apiesse/knxRoomUnit/hardware/knxRoomUnit/production/knxRoomUnit_r1d1_2024-01-23_12-25-09/knxRoomUnit_r1d1.pdf

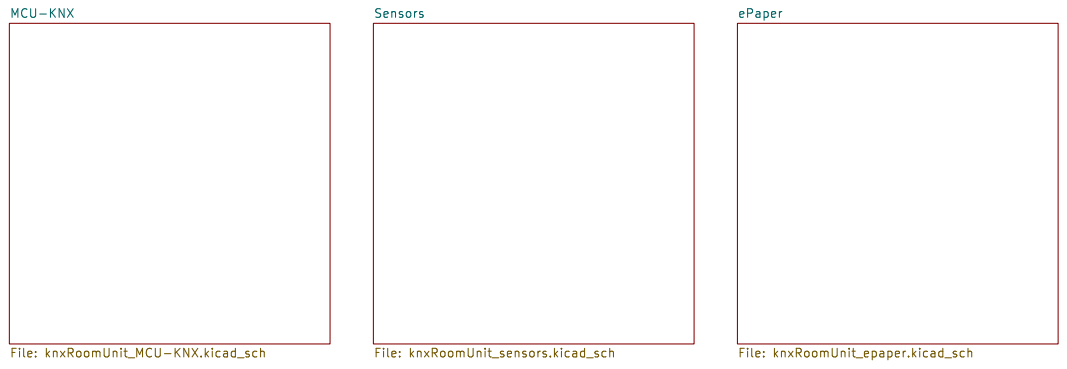
[picture p1: page 1]
D Date: 2024-01-21 KiCad; kicad; 7.0.10 Size: A4; Rev: r1d1; File: knxRoomUnit_MCU-KNX.kicad_sch

ePaper File: knxRoomUnit_epaper.kicad_sch Sensors File: knxRoomUnit_sensors.kicad_sch MCU-KNX

Id: 1/4 Title: knxRoomUnit File: knxRoomUnit.kicad_sch Sheet: / MP

# SW1 RESET R3

# R5 10k GND GND

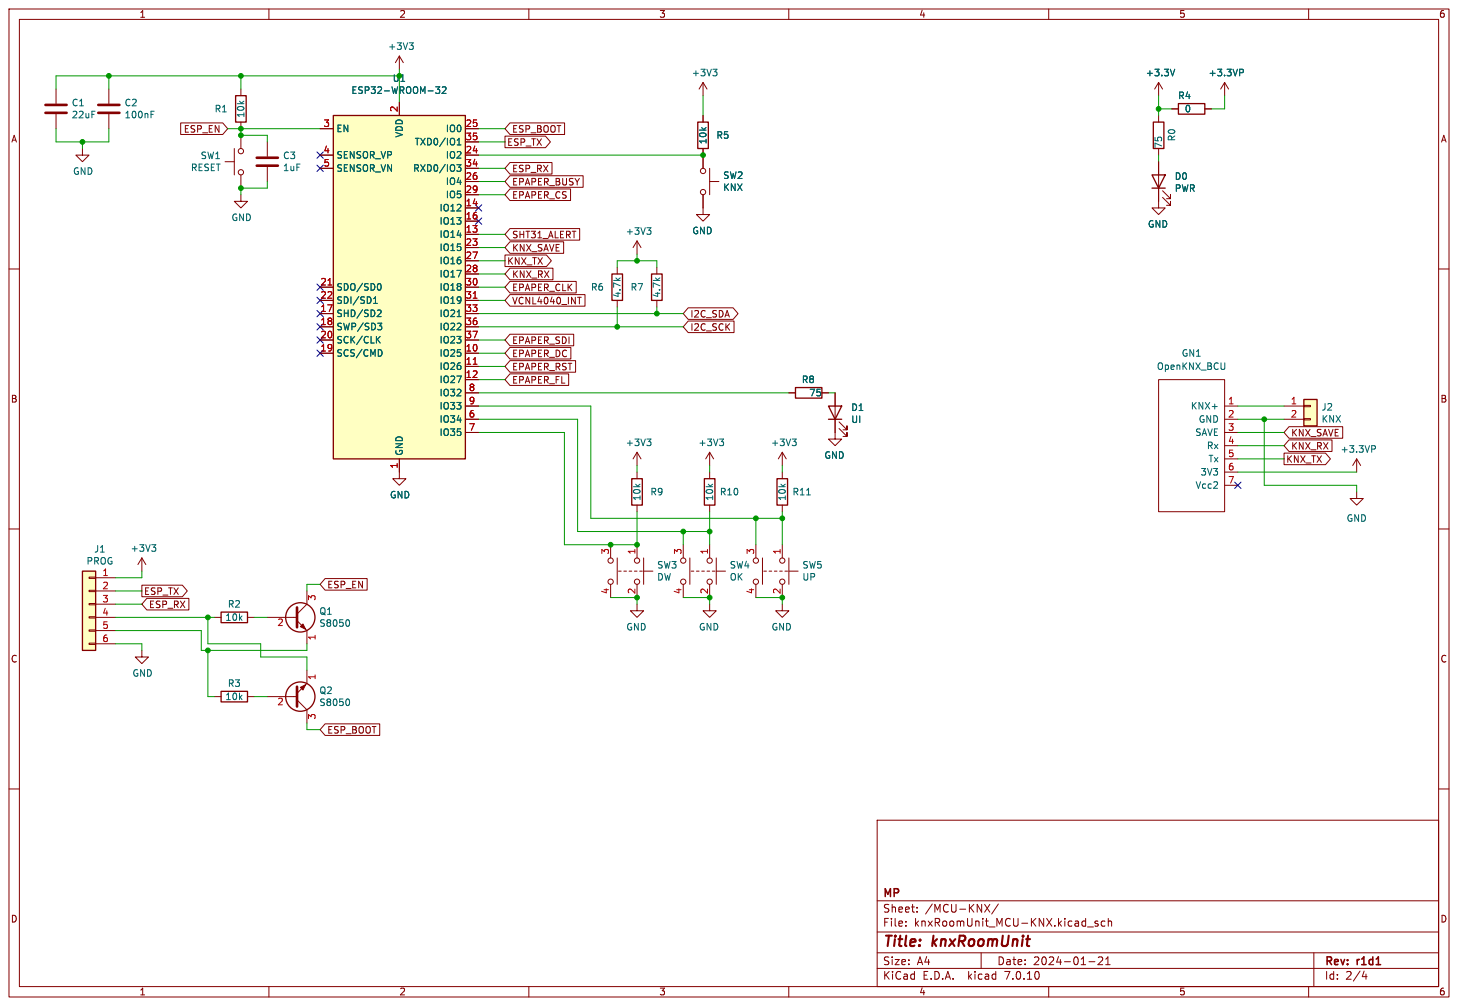
[picture p2: page 2]

2 SCK/CLK 20 SDO/SD0 21 SDI/SD1 22

3 Q1 S8050 KNX+ 1 GND 2 SAVE 3 Rx 4 Tx 5

Id: 2/4 Title: knxRoomUnit File: knxRoomUnit_MCU-KNX.kicad_sch Sheet: /MCU-KNX/ MP

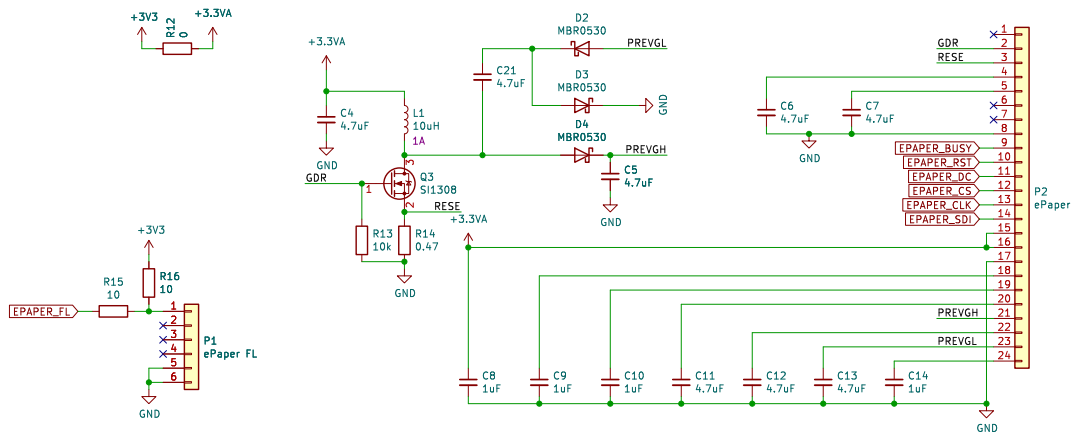
[picture p3: page 3]

Id: 3/4 Title: knxRoomUnit File: knxRoomUnit_epaper.kicad_sch Sheet: /ePaper/ MP

# Logic OSCI PD

0R19

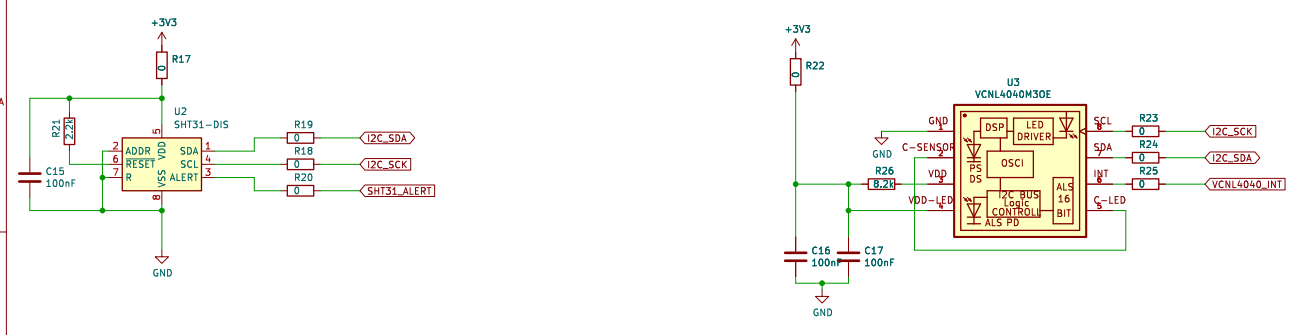
[picture p4: page 4]

Id: 4/4 Title: knxRoomUnit File: knxRoomUnit_sensors.kicad_sch Sheet: /Sensors/ MP

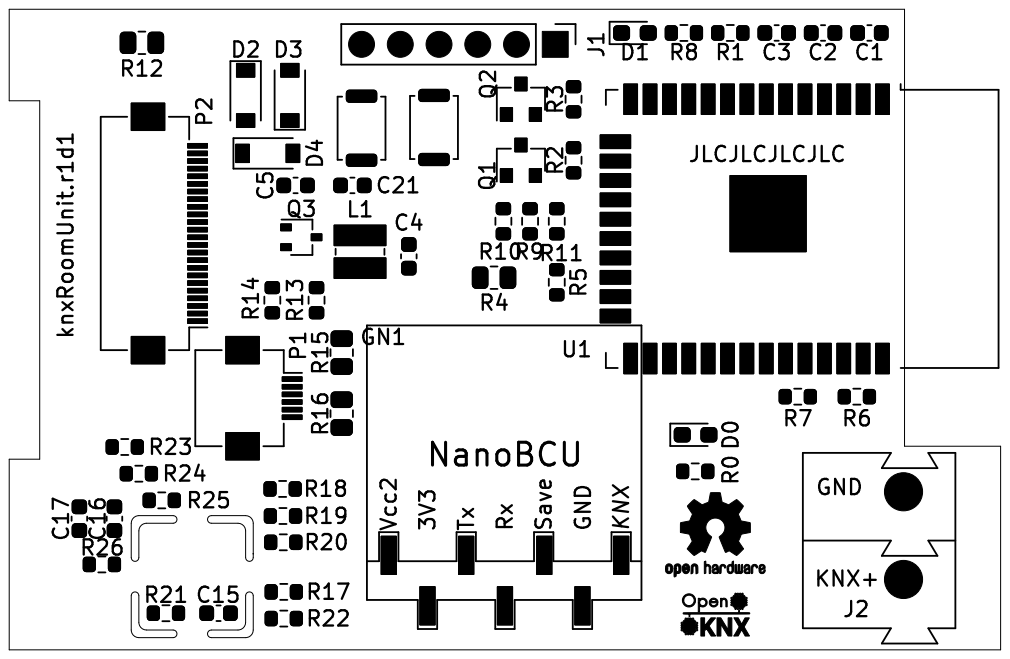
[picture p5: page 5]

Id: 1/1 Title: knxRoomUnit File: knxRoomUnit.kicad_pcb Sheet: MP

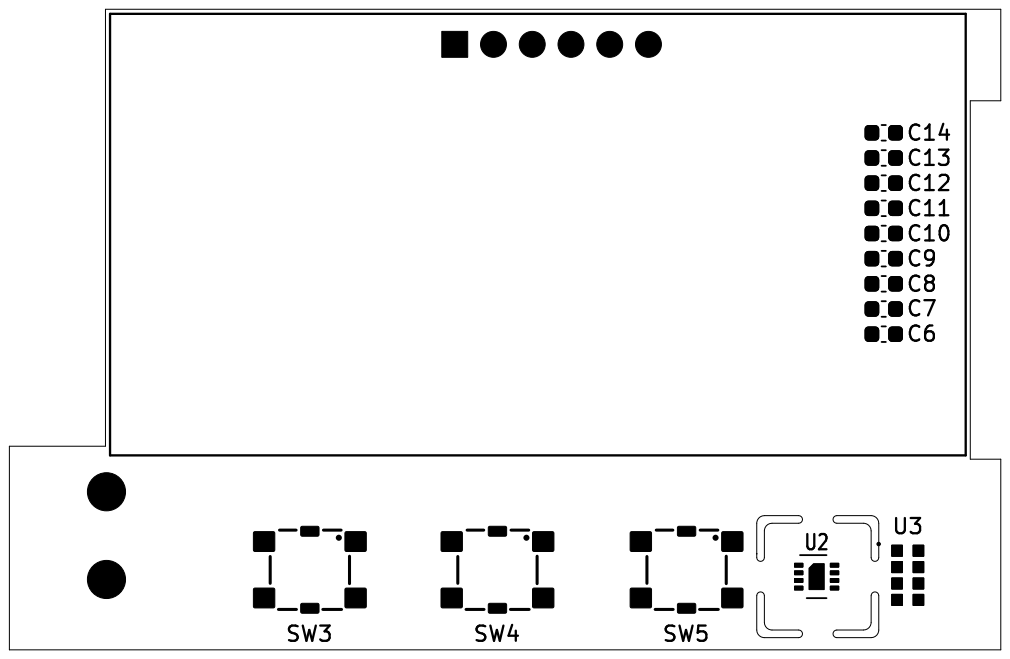
[picture p6: page 6]

Id: 1/1 Title: knxRoomUnit File: knxRoomUnit.kicad_pcb Sheet: MP
