apiesse/knxRoomUnit/hardware/knxRoomUnit/knxRoomUnit.kicad_pcb

## KiCad design hardware/knxRoomUnit/knxRoomUnit.kicad_pcb (2024-01-23)

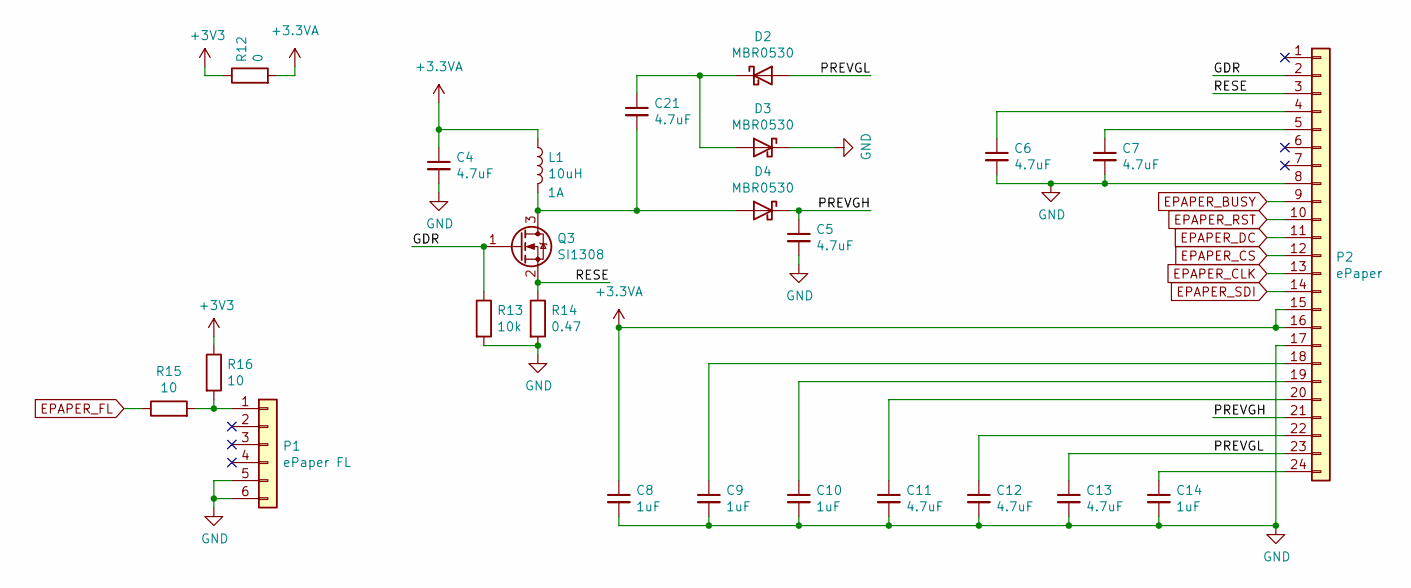
[picture p7: schematic knxRoomUnit_epaper.kicad_sch, knxRoomUnit]

Parts:
C4, C5, C6, C7, C11, C12, C13, C21: 4.7uF; C_0603_1608Metric; Voltage 16V; PartNumber CL10A475KO8NNNC; LCSC Part # C19666
C8, C9, C10, C14: 1uF; C_0603_1608Metric; Voltage 50V; PartNumber CL10A105KB8NNNC; LCSC Part # C15849
D2, D3, D4: MBR0530; D_SOD-123; PartNumber MBR0530; LCSC Part # C5204746
L1: 10uH; L_Wuerth_MAPI-3020; Voltage 1A; PartNumber XFL3012-103MEC
P1: ePaper FL; Hirose_FH12-6S-0.5SH_1x06-1MP_P0.50mm_Horizontal; PartNumber AFC34-S06FIA-00; LCSC Part # C2842522
P2: ePaper; Hirose_FH12-24S-0.5SH_1x24-1MP_P0.50mm_Horizontal; PartNumber AFC34-S24FIA-00; LCSC Part # C2842527
Q3: SI1308; SOT-323_SC-70; PartNumber SI1308EDL-T1-GE3; LCSC Part # C469327
R12: 0; R_0805_2012Metric; PartNumber 0805W8F0000T5E; LCSC Part # C17477
R13: 10k; R_0603_1608Metric; PartNumber 0603WAF1002T5E; LCSC Part # C25804
R14: 0.47; R_0603_1608Metric
R15: 10; R_0805_2012Metric; PartNumber 0805W8F100JT5E; LCSC Part # C17415
R16: 10; R_0805_2012Metric; PartNumber 0805W8J0100T5E; LCSC Part # C25278

Connections:
+3.3VA: C4.1, C8.1, L1.1, P2.15, P2.16, R12.2
/ePaper/GDR: P2.2, Q3.1 (G), R13.1
/ePaper/PREVGH: C5.1, D4.1 (K), P2.21
/ePaper/PREVGL: C13.1, D2.2 (A), P2.23
/ePaper/RESE: P2.3, Q3.2 (S), R14.1
EPAPER_BUSY: P2.9; also elsewhere on the board
EPAPER_CLK: P2.13; also elsewhere on the board
EPAPER_CS: P2.12; also elsewhere on the board
EPAPER_DC: P2.11; also elsewhere on the board
EPAPER_FL: R15.1; also elsewhere on the board
EPAPER_RST: P2.10; also elsewhere on the board
EPAPER_SDI: P2.14; also elsewhere on the board
GND: C4.2, C5.2, C6.2, C7.2, C8.2, C9.2, C10.2, C11.2, C12.2, C13.2, C14.2, D3.1 (K), P1.5, P1.6, P2.8, P2.17, R13.2, R14.2; also elsewhere on the board
unnamed: C21.1, D2.1 (K), D3.2 (A)
unnamed: C21.2, D4.2 (A), L1.2, Q3.3 (D)
unnamed: P1.1, R15.2, R16.2
unnamed: C6.1, P2.4
unnamed: C7.1, P2.5
unnamed: C9.1, P2.18
unnamed: C10.1, P2.19
unnamed: C11.1, P2.20
unnamed: C12.1, P2.22
unnamed: C14.1, P2.24

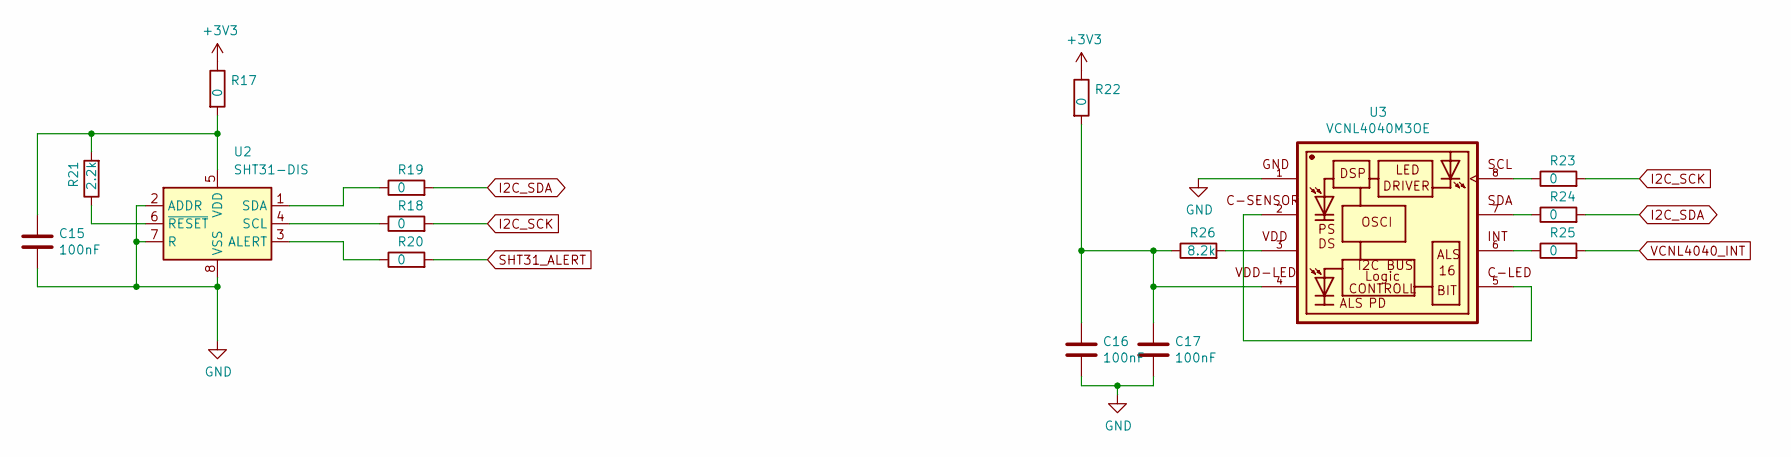
[picture p8: schematic knxRoomUnit_sensors.kicad_sch, knxRoomUnit]

Parts:
C15, C16, C17: 100nF; C_0603_1608Metric; Voltage 50V; PartNumber CC0603KRX7R9BB104; LCSC Part # C14663
R17, R18, R19, R20, R22, R23, R24, R25: 0; R_0603_1608Metric; PartNumber 0603WAF0000T5E; LCSC Part # C21189
R21: 2.2k; R_0603_1608Metric; PartNumber 0603WAF2201T5E; LCSC Part # C4190
R26: 8.2k; R_0603_1608Metric; PartNumber 0603WAF8201T5E; LCSC Part # C25981
U2: SHT31-DIS; Sensirion_DFN-8-1EP_2.5x2.5mm_P0.5mm_EP1.1x1.7mm; PartNumber SHT31-DIS-B2.5kS; LCSC Part # C80862
U3: VCNL4040M3OE; VISHAY_VCNL4040_4X2X1.1; PartNumber VCNL4040M3OE; LCSC Part # C142526

Connections:
GND: C15.2, C16.2, C17.2, U2.2 (ADDR), U2.7 (R), U2.8 (VSS), U2.9 (VSS), U3.1; also elsewhere on the board
I2C_SCK: R18.2, R23.2; also elsewhere on the board
I2C_SDA: R19.2, R24.2; also elsewhere on the board
unnamed: C16.1, C17.1, R22.2, R26.1, U3.4
unnamed: R23.1, U3.8
unnamed: R24.1, U3.7
unnamed: R25.1, U3.6
unnamed: R26.2, U3.3
unnamed: R20.1, U2.3 (ALERT)
unnamed: R18.1, U2.4 (SCL)
unnamed: R19.1, U2.1 (SDA)
unnamed: C15.1, R17.2, R21.2, U2.5 (VDD)
unnamed: R21.1, U2.6 (~RESET)
unnamed: U3.2, U3.5
SHT31_ALERT: R20.2; also elsewhere on the board
VCNL4040_INT: R25.2; also elsewhere on the board

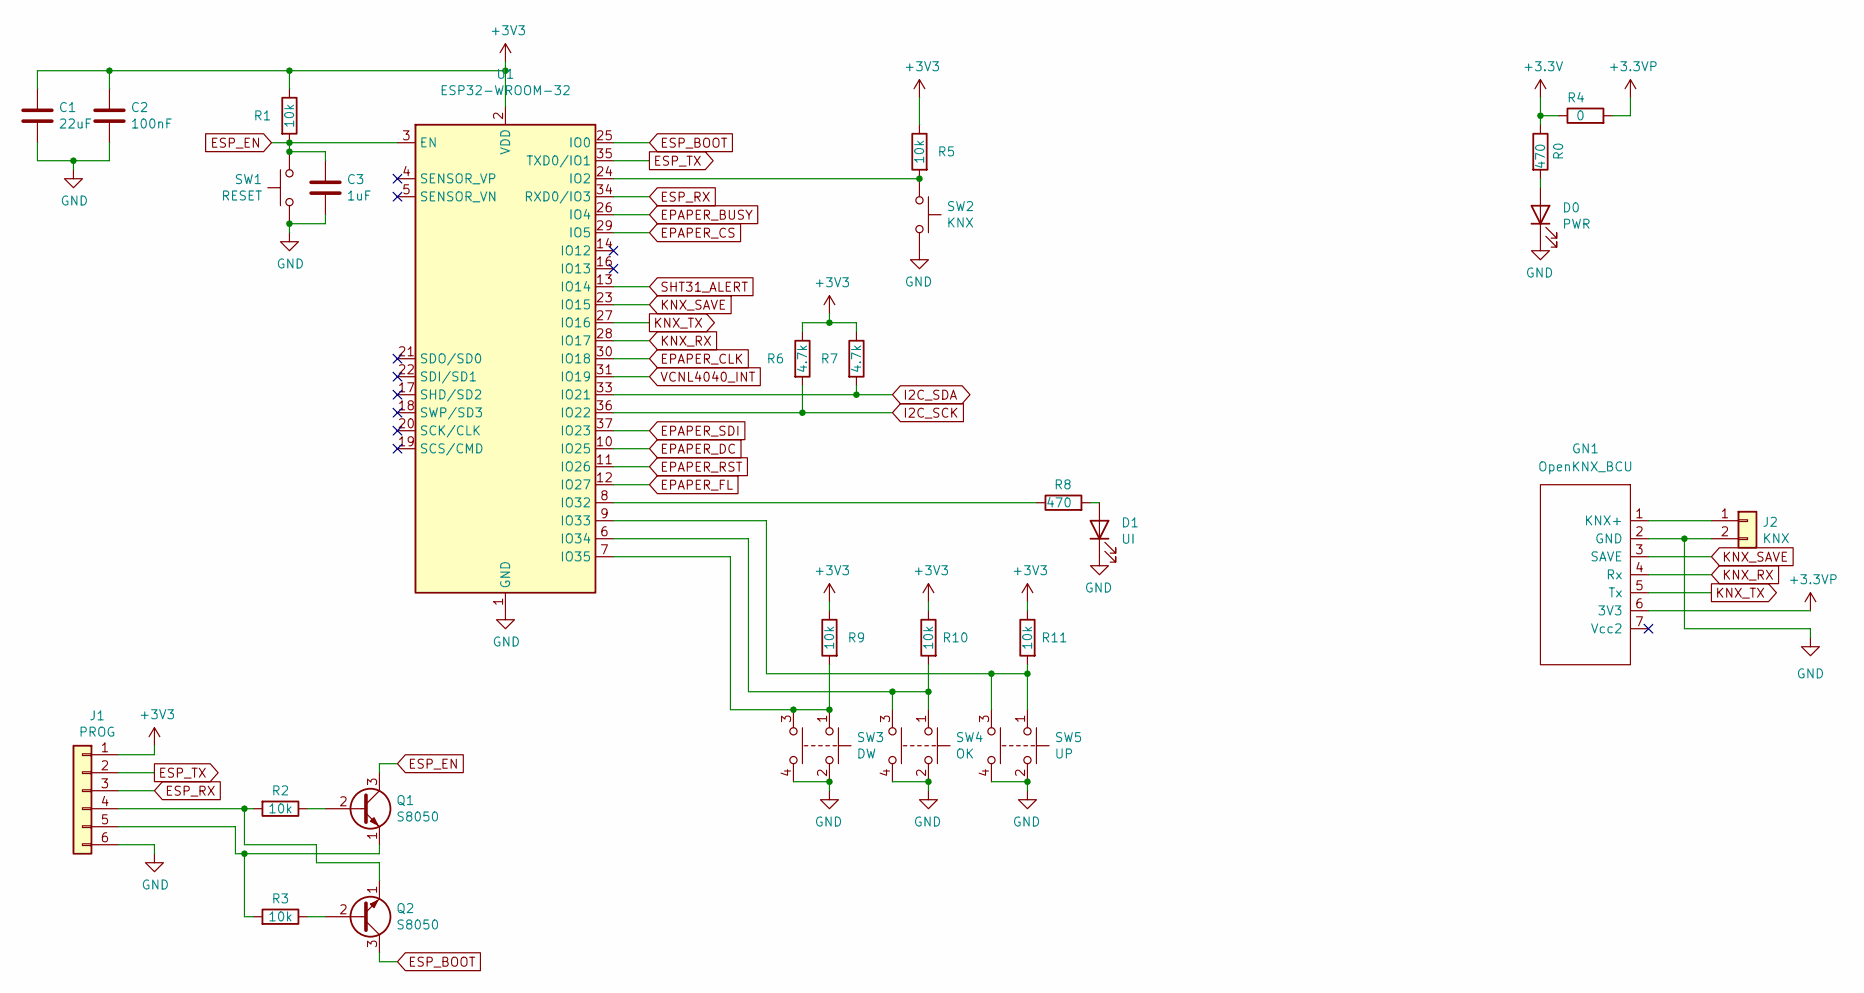
[picture p9: schematic knxRoomUnit_MCU-KNX.kicad_sch, knxRoomUnit]

Parts:
C1: 22uF; C_0603_1608Metric; Voltage 6.3V; PartNumber CL10A226MQ8NRNC; LCSC Part # C59461
C2: 100nF; C_0603_1608Metric; Voltage 50V; PartNumber CC0603KRX7R9BB104; LCSC Part # C14663
C3: 1uF; C_0603_1608Metric; Voltage 50V; PartNumber CL10A105KB8NNNC; LCSC Part # C15849
D0: PWR; LED_0603_1608Metric_Pad1.05x0.95mm_HandSolder
D1: UI; LED_0603_1608Metric_Pad1.05x0.95mm_HandSolder
GN1: OpenKNX_BCU; NanoBCU_PinHeader_SMD_low_profile
J1: PROG; PinHeader_1x06_P2.54mm_Vertical
J2: KNX; KNX_Connector
Q1, Q2: S8050; SOT-23; PartNumber SS8050; LCSC Part # C2150
R0, R8: 470; R_0603_1608Metric; PartNumber 0603WAF4700T5E; LCSC Part # C23179
R1, R2, R3, R5, R9, R10, R11: 10k; R_0603_1608Metric; PartNumber 0603WAF1002T5E; LCSC Part # C25804
R4: 0; R_0805_2012Metric; PartNumber 0805W8F0000T5E; LCSC Part # C17477
R6, R7: 4.7k; R_0603_1608Metric; PartNumber 0603WAF4701T5E; LCSC Part # C23162
SW1: RESET; SW_Push_SPST_NO_Alps_SKRK
SW2: KNX; SW_Push_SPST_NO_Alps_SKRK
SW3: DW; 431151008826; PartNumber 431151008826
SW4: OK; 431151008826; PartNumber 431151008826
SW5: UP; 431151008826; PartNumber 431151008826
U1: ESP32-WROOM-32; PartNumber ESP32-WROOM-32E

Connections:
+3.3VP: GN1.6 (3V3), R4.2
EPAPER_BUSY: U1.26 (IO4); also elsewhere on the board
EPAPER_CLK: U1.30 (IO18); also elsewhere on the board
EPAPER_CS: U1.29 (IO5); also elsewhere on the board
EPAPER_DC: U1.10 (IO25); also elsewhere on the board
EPAPER_FL: U1.12 (IO27); also elsewhere on the board
EPAPER_RST: U1.11 (IO26); also elsewhere on the board
EPAPER_SDI: U1.37 (IO23); also elsewhere on the board
ESP_BOOT: Q2.3 (C), U1.25 (IO0)
ESP_EN: C3.1, Q1.3 (C), R1.2, SW1.1, U1.3 (EN)
ESP_RX: J1.3, U1.34 (RXD0/IO3)
ESP_TX: J1.2, U1.35 (TXD0/IO1)
GND: C1.2, C2.2, C3.2, D0.1 (K), D1.1 (K), GN1.2 (GND), J1.6, J2.2, SW1.2, SW2.2, SW3.2, SW3.4, SW4.2, SW4.4, SW5.2, SW5.4, U1.1 (GND), U1.15 (GND), U1.38 (GND), U1.39 (GND); also elsewhere on the board
I2C_SCK: R6.2, U1.36 (IO22); also elsewhere on the board
I2C_SDA: R7.2, U1.33 (IO21); also elsewhere on the board
KNX_RX: GN1.4 (Rx), U1.28 (IO17)
KNX_SAVE: GN1.3 (SAVE), U1.23 (IO15)
KNX_TX: GN1.5 (Tx), U1.27 (IO16)
unnamed: D0.2 (A), R0.2
unnamed: D1.2 (A), R8.2
unnamed: GN1.1 (KNX+), J2.1
unnamed: J1.4, Q2.1 (E), R2.2
unnamed: J1.5, Q1.1 (E), R3.2
unnamed: Q1.2 (B), R2.1
unnamed: Q2.2 (B), R3.1
unnamed: R5.2, SW2.1, U1.24 (IO2)
unnamed: R8.1, U1.8 (IO32)
unnamed: R11.2, SW5.1, SW5.3, U1.9 (IO33)
unnamed: R10.2, SW4.1, SW4.3, U1.6 (IO34)
unnamed: R9.2, SW3.1, SW3.3, U1.7 (IO35)
SHT31_ALERT: U1.13 (IO14); also elsewhere on the board
VCNL4040_INT: U1.31 (IO19); also elsewhere on the board

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
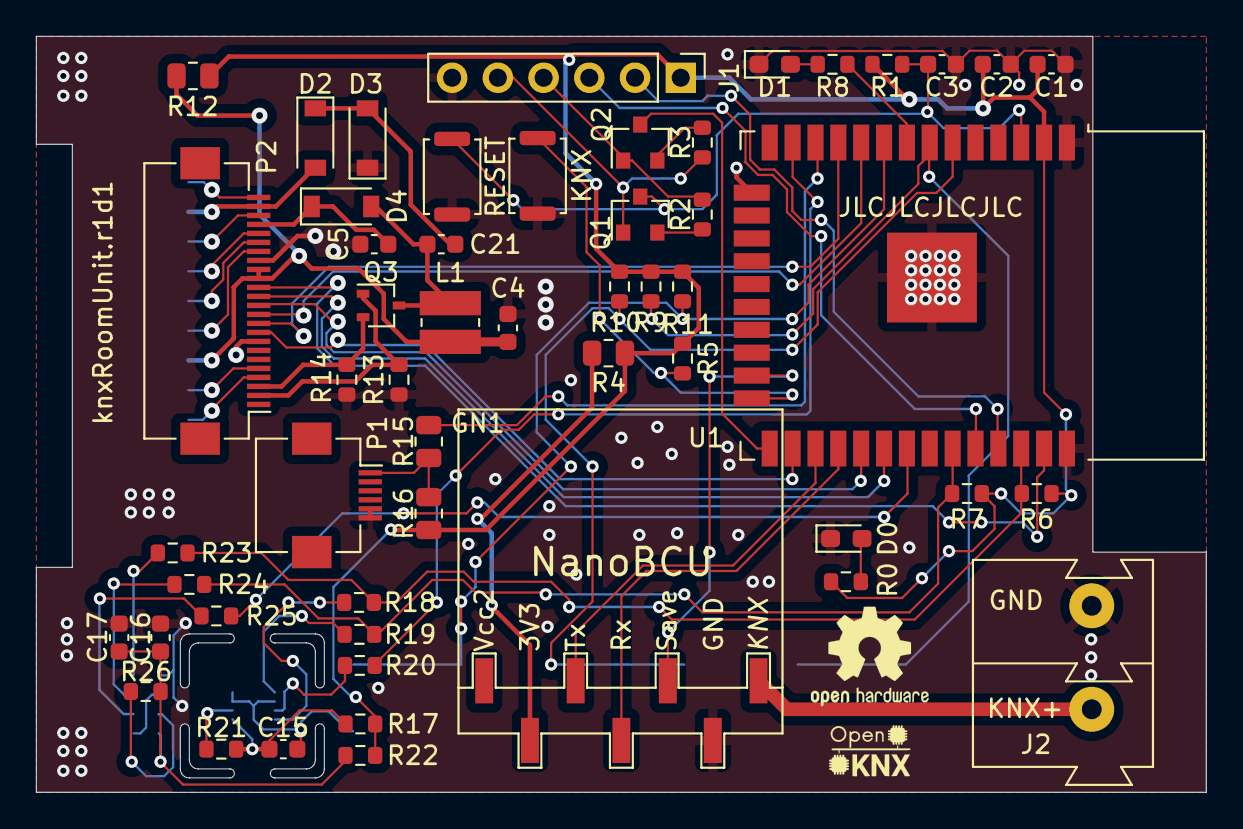
[picture p10: board knxRoomUnit.kicad_pcb from above]

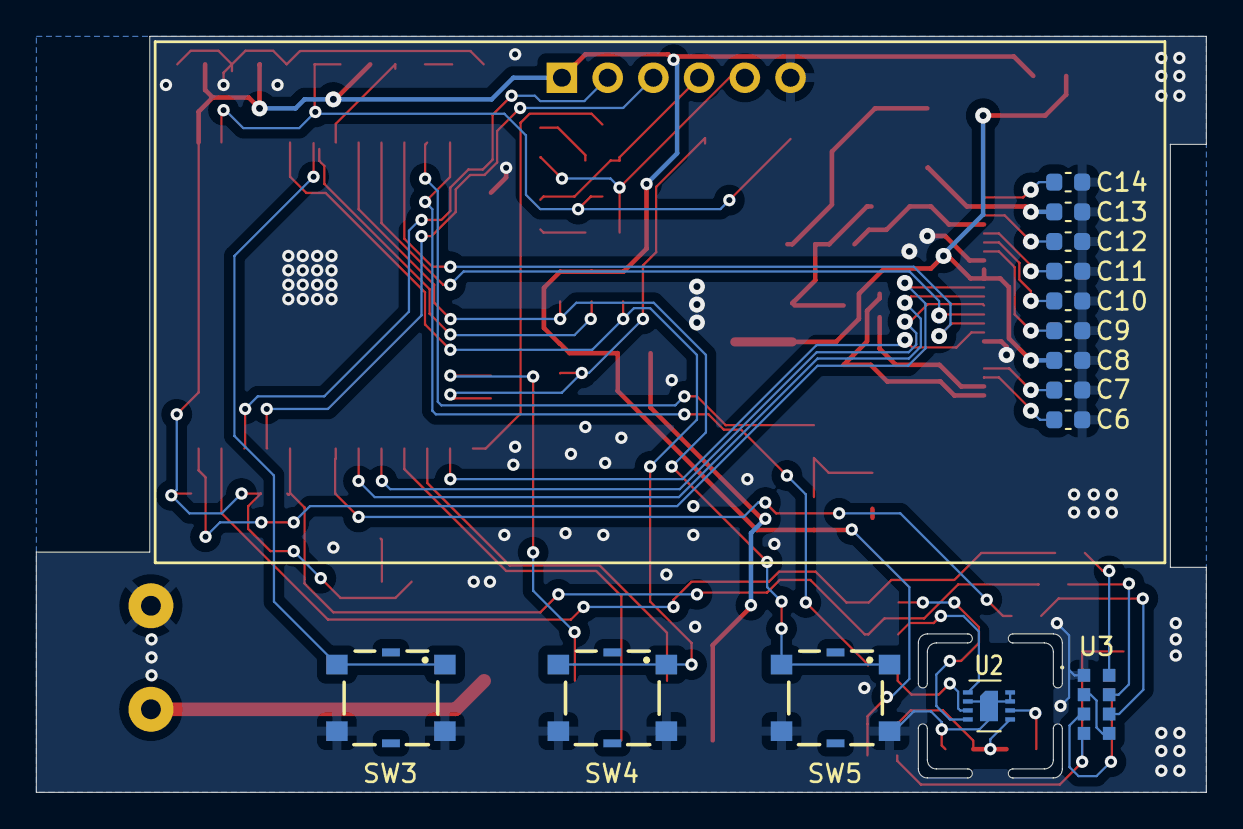
[picture p11: board knxRoomUnit.kicad_pcb from below]

Board: 2 copper layers, 65.0 x 42.0 mm, 67 parts (14 on the bottom side), 59 nets.
