apiesse/knxRoomUnit/(commit log)

2022-01-04 KnxRoomUnit hardware
    Added KnxRoomUnit hardware repository
    [431151008826 (rev1).stp, FrqXTAL_CFPX-180.stp, QFN40-6X6.step, VCNL4040M3OE.step, Wago_243_211.step, knxRoomSensor_MCU.kicad_sch, knxRoomUnit.kicad_pcb, knxRoomUnit.kicad_sch]
2023-08-22 Initial hardware commit
    [431151008826 (rev1).stp, FrqXTAL_CFPX-180.stp, QFN40-6X6.step, VCNL4040M3OE.step, Wago_243_211.step, knxRoomSensor_MCU.kicad_sch, knxRoomUnit.kicad_pcb, knxRoomUnit.kicad_sch]
2023-08-22 Hardware Update
    [knxRoomSensor_MCU.kicad_sch, knxRoomUnit.kicad_pcb, knxRoomUnit.kicad_sch]
2023-08-22 Added VCNL4040 Kicad library
2023-08-22 Updated sensors
    [knxRoomUnit.kicad_pcb, knxRoomUnit.kicad_sch, knxRoomUnit_MCU-KNX.kicad_sch, knxRoomUnit_epaper.kicad_sch, knxRoomUnit_sensors.kicad_sch]
2024-01-03 Update OpenKNX-KiCad-Lib
    Updated OpenKNX-KiCad-Lib
2024-01-03 PCB routing
    [knxRoomUnit.kicad_pcb, knxRoomUnit_MCU-KNX.kicad_sch, knxRoomUnit_sensors.kicad_sch]
2024-01-05 Finished PCB routing
    [knxRoomUnit.kicad_pcb, knxRoomUnit_MCU-KNX.kicad_sch]
2024-01-07 Production adjustments
    [knxRoomUnit.kicad_pcb, knxRoomUnit_MCU-KNX.kicad_sch, knxRoomUnit_epaper.kicad_sch, knxRoomUnit_sensors.kicad_sch]
2024-01-07 Added HW production files
    [bom.csv, designators.csv, positions.csv]
2024-01-08 Fixed directory structure
    [bom.csv, designators.csv, knxRoomUnit_MCU-KNX.kicad_sch, positions.csv]
2024-01-08 Fixed HW production files
    [bom.csv, designators.csv, knxRoomUnit.kicad_pcb, positions.csv]
2024-01-21 Updated HW design
    Flipped P1 to match display's pinout
    Changed 0201 resistors to 0603
    Added R12 to section 3V3 to display
    [knxRoomUnit.kicad_pcb, knxRoomUnit.kicad_sch, knxRoomUnit_MCU-KNX.kicad_sch, knxRoomUnit_epaper.kicad_sch, knxRoomUnit_sensors.kicad_sch]
2024-01-23 Updated HW design
    Changed R0/R8 to 470R
    PCB routing and DRC
    [knxRoomUnit.kicad_pcb, knxRoomUnit_MCU-KNX.kicad_sch]
